engr-abdullah043/Tail_Light_Firmware/Docs/3d_model.jpeg

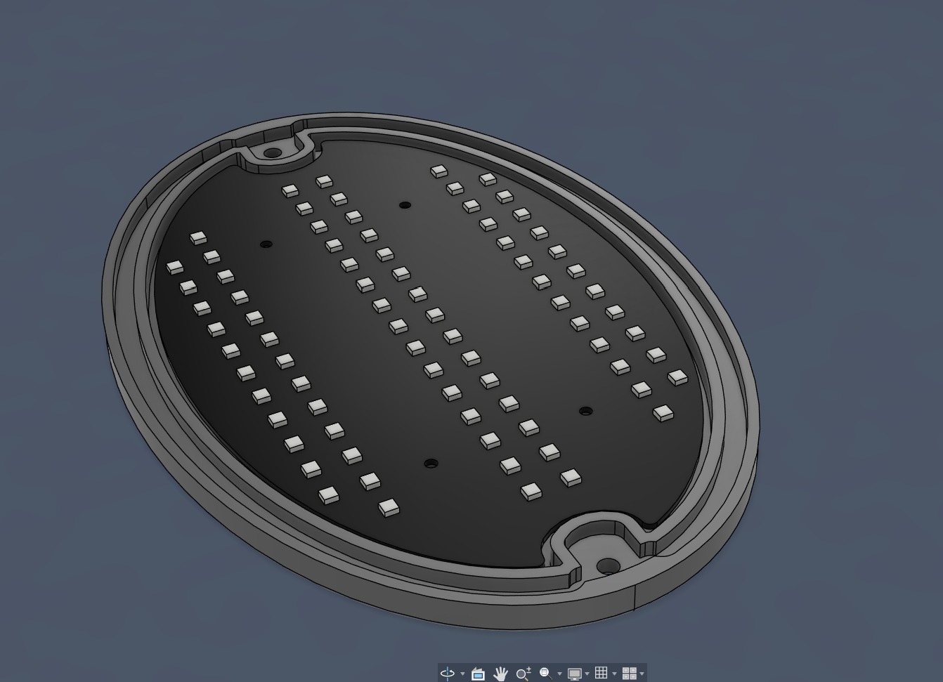
Docs/3d_model.jpeg
