engr-abdullah043/Tail_Light_Firmware/Docs/schematic_1.jpeg

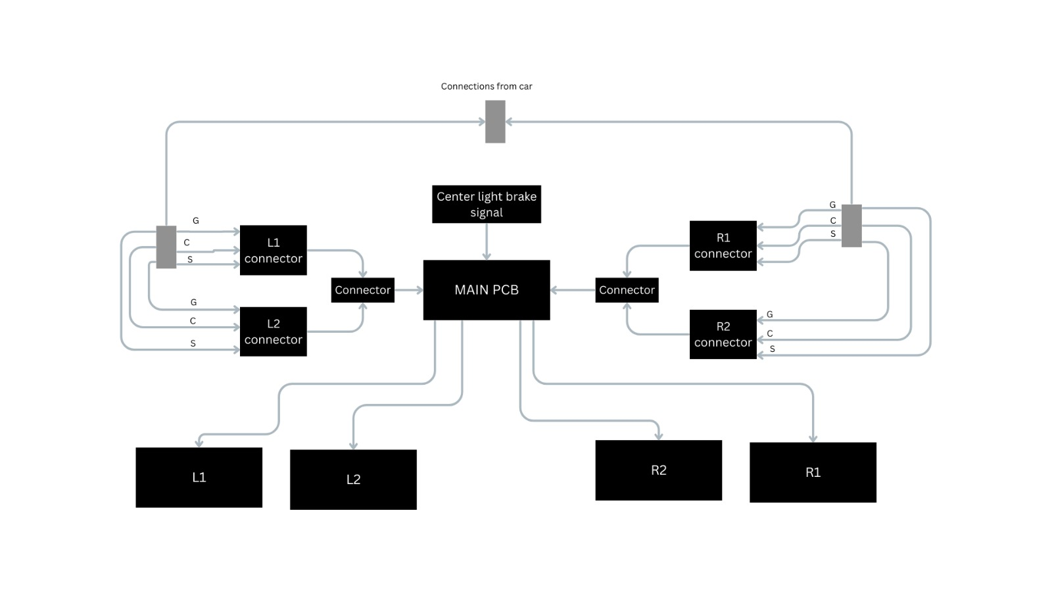
Docs/schematic_1.jpeg
