engr-abdullah043/Tail_Light_Firmware/Docs/schematic_layout.jpeg

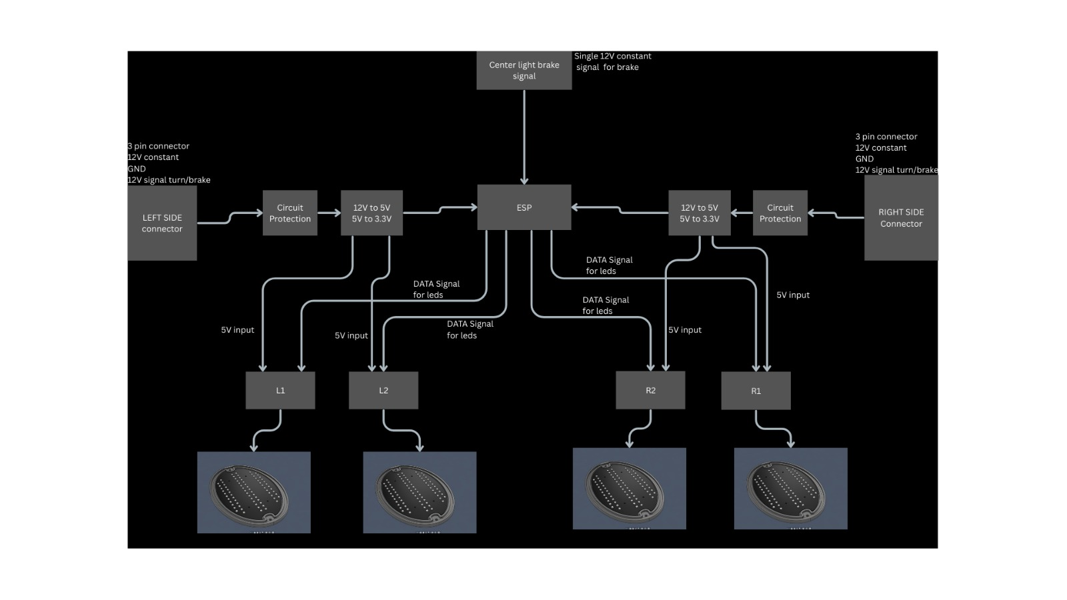
Docs/schematic_layout.jpeg
