engr-abdullah043/Tail_Light_Firmware/Docs/signals.jpeg

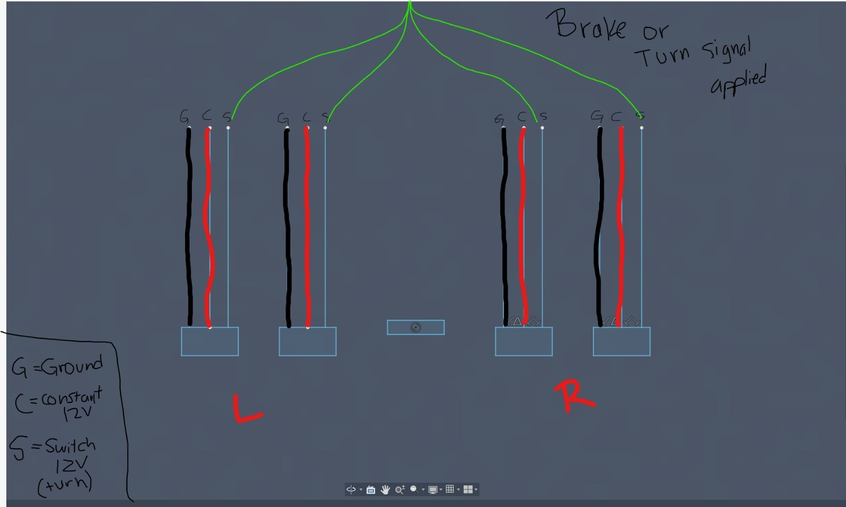
Docs/signals.jpeg
