engr-abdullah043/Tail_Light_Firmware/Docs/Tail Light Component selection.docx

1: Double Point Led Light Bulbs For Car And Bikes Pack of 2 1157 BAY15D For Brake Light Or Turn Signal Waterproof High Quality Super Brightness Hazard Blinker Lights

2: CANBUS LED Turn Signal Indicator Bulbs For Car Amber Yellow 1156 BA15S 12-24V Waterproof High Quality Super Brightness 3014 144 SMD 7506 1003 1073 Hazard Lights

Block / Section | Component (Recommended) | Color / Type | Qty / Configuration | Voltage & Current | Use / Purpose
LED – Tail / Brake | High-brightness 3030 SMD LED (Automotive grade, e.g. from ams OSRAM) | Red | 32 LEDs total → 4S × 8P (4 in series, 8 parallel strings) | Vf ≈ 2.0 –2.2 V per LED~100 mA per stringTotal ≈ 0.8 A @ full brake | Main rear tail & brake light. Running mode at 40% PWM, brake at 100% PWM
LED – Turn Signal | High-brightness 3030 SMD LED (Automotive grade) | Amber | 24 LEDs total → 4S × 6P | Vf ≈ 2.0–2.3 V per LED~100 mA per stringTotal ≈ 0.6 A | Turn indicator / hazard. Blink at 1–2 Hz. If needed, ON phase at 70% PWM
Why 4 LEDs in Series (4S) | — | — | — | Designed for 12–14.4 V car system | Best efficiency, less heat, stable brightness during charging voltage
Controller (Logic) | ESP32-WROOM-32 | MCU | 1 | 3.3 V logic | Reads brake/turn/running inputs, applies priority logic, generates PWM & blink timing
LED Driver (Recommended – Production) | Constant-current buck LED driver (e.g. from Texas Instruments / onsemi) | Driver IC | 1 per channel | Wide input (≥40 V), set LED current | Keeps LED brightness stable across voltage & temperature; safest for production
LED Switching (Prototype option) | Logic-level N-MOSFET + gate resistor + pulldown | Power stage | 1 per channel | ≥30–40 V MOSFET | Simple PWM control in prototype; LED current set by resistors (not ideal for final)
Power Conversion | 12 V → 5 V buck + 5 V → 3.3 V regulator | Power | 1 set | 12–14.4 V input | Safely powers ESP32 from vehicle battery
Protection – Fuse | Automotive blade fuse | Safety | 1 | 5–10 A (depends on total LED current) | Protects wiring & PCB from short circuits
Protection – Reverse Polarity | P-MOSFET or diode | Safety | 1 | Battery line | Prevents damage if battery is connected backwards
Protection – Bulk Capacitor | Electrolytic capacitor | Safety | 1 | 470–1000 µF / ≥25 V | Absorbs voltage dips and spikes
Inputs (Office Prototype) | Push buttons + ESP32 pull-ups | Input | 3 | 3.3 V logic | Simulates RUN / BRAKE / TURN signals
Inputs (Vehicle Final) | Protected 12 V inputs (divider or optocoupler) | Input | 3 | 12 V automotive | Safely reads real car signals without noise or spikes
Thermal Design | Wide copper pours + thermal pads | PCB | — | — | Keeps LEDs cool to maintain brightness & lifetime
