engr-abdullah043/Tail_Light_Firmware/Docs/Tail Light Component selection_updated.docx

Block / Section | Exact recommended part (production)
Red LEDs (Tail/Brake strip) | ams OSRAM OSLON Signal – LJ CRBP.01-JZLX-27-3A4A-350-R18
Amber LEDs (Turn/Hazard strip) | ams OSRAM OSLON SX – LA CN5M-FBGB-24-1-140-R18-Z
LED Driver (2 channels) | MPS MPQ7210-AEC1 (AEC-Q100)
MCU / Controller | Espressif ESP32-WROOM-32E (e.g., ESP32-WROOM-32E-N4)
12V → 5V buck (Automotive) | TI LM53603AQPWPTQ1
5V → 3.3V LDO (Automotive) | TI TLV76733QWDRBRQ1
Fuse holder (inline, sealed) | Littelfuse FHAC0001ZXJ
Fuse (example safe choice) | Littelfuse 0997005.WXN (Mini blade, 5A)
Reverse polarity protection | Nexperia BUK6Y24-40P (AEC-Q101)
Battery transient / surge clamp (TVS) | SMBJ58A (or automotive “-Q” variant like SMBJ58A-Q)
String balancing resistors (per parallel string) | Yageo PT2512FK-7W0R47L (0.47Ω, AEC-Q200)
Power inductor (per buck channel) | Coilcraft XAL7030-103MEB (10µH, AEC-Q200 family)

Production BOM (recommended parts):

Prototype BOM (Best selections from in-house stock):

Sr. | Block / Section | Best selection (from your stock) | Purpose / Use in prototype | Notes (important)
1 | MCU + Bluetooth | ESP32-WROOM-32 | Main controller; reads RUN/BRAKE/TURN buttons; generates PWM & blink | Best choice for fast prototyping (PWM + BLE)
2 | LEDs (available stock) | WS2815 RGBW (12V type) | Visual demo of patterns + logic | If the project is single-color red/amber, this is only for demo. Real brightness/thermal won’t match final design
3 | LED Driver IC (stock) | CAT4101 | Constant current driving for small LED test loads | Useful for controlled current tests, but not a full 12V buck driver for big strip power (thermal/architecture limits)
4 | Power MOSFET | AO3400A | Low-side switching for Red/Amber channels (PWM from ESP32) | Best among listed for switching loads in prototype
5 | Buck Converter | TPS54202 | 12V → 5V for ESP32 and logic | Cleaner and more reliable vs LM2596 class for prototyping
6 | Reverse Polarity Protection | PMOS reverse protection (preferred) | Protects if supply polarity is reversed | Better than SS34 (less voltage drop); SS34 can be fallback
7 | TVS (Transient suppression) | SM8S36A | Clamps surges/spikes on 12V input | Strongest clamp option among your TVS list (higher surge capability)
8 | Input Signal Conditioning (optional) | TLV2372 | Buffer/condition brake/turn/running inputs | For office buttons, not required; helpful later for noisy vehicle signals
9 | Current Sense Resistor | 0.1Ω 1% | Measuring current during prototype + basic protection | Easier to measure voltage drop than 0.05Ω; still low loss
10 | Bluetooth Antenna | PCB trace antenna (ESP32 module) | Wireless comms | Simplest + reliable for prototype
11 | Crystal Oscillator | Internal (ESP32 module) | Clock | External crystal usually not needed if using ESP32 module
12 | Power Connector | Screw Terminal | Easy bench wiring for 12V input + LED outputs | Best for lab prototype (quick connect/disconnect)
13 | Programming Interface | CP2102 | Flashing/debugging | Most stable/common option
14 | PCB Substrate | FR4 TG170 | PCB reliability/temperature margin | Better temp margin than TG150 for automotive-like environment
